darkmarthur/FADETUBE_DJ_MIDI_CONTROLLER/FADETUBE_MIDI/production/TEST_JLC_bom.csv

Designator | Footprint | Quantity | Value | LCSC Part #
ARDUINOPROMICROATMEGA32U4USBC-1 | Sparkfun_Pro_Micro | 1 | SPARKFUN QWIIC PRO MICRO - USB-C
C1 | CAPC1608X90 | 1 | 0.1 µF
C2 | CAPC2012X88N | 1 | 10 µF
FADER1 | TRIM_PTA4553-2215CIB103 | 1 | PTA4553-2215CIB103 10k 45mm
J1_DECK_A1, J2_DECK_B1 | JST_B8B-PH-K-S | 2 | B8B-PH-K-S
ROTARY_ENCODER_BTN1 | XDCR_PEC11R-4220K-S0024 | 1 | PEC11R-4220K-S0024 10k
R_LOAD_A1, R_LOAD_B1, R_PLAY_A1, R_PLAY_B1 | RESC1608X55 | 4 | 470 Ohms
