darkmarthur/FADETUBE_DJ_MIDI_CONTROLLER/3D_PROTOTYPE/FADETUBE_DJ_MIDI_CONTROLLER_Slices.3mf

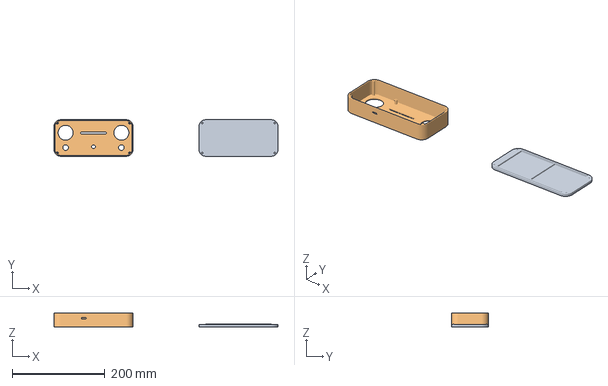
[picture p1: CAD file, 2026-02-12]
3D_PROTOTYPE/FADETUBE_DJ_MIDI_CONTROLLER_Slices.3mf
482.0 x 78.6 x 30.2 mm
FADETUBE_DJ_MIDI_CONTROLLER_v2_Bottom.stl
FADETUBE_DJ_MIDI_CONTROLLER_Top.stl
