darkmarthur/FADETUBE_DJ_MIDI_CONTROLLER/3D_PROTOTYPE/FADETUBE_DJ_MIDI_CONTROLLER_v2_Bottom.stl

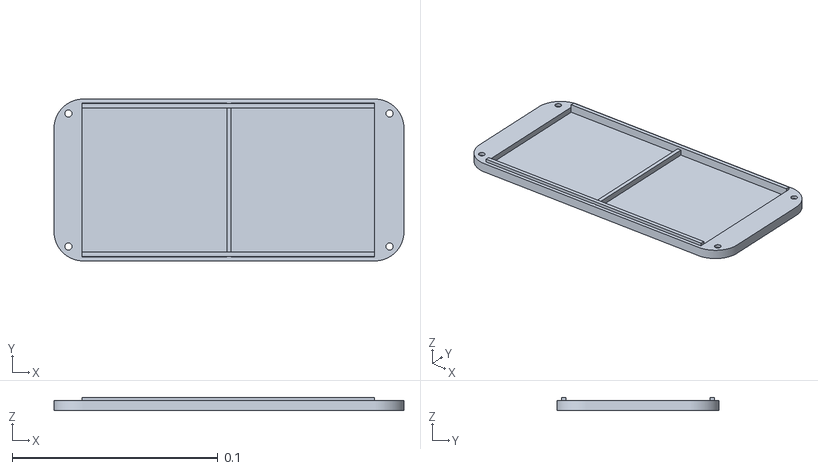
[picture p2: CAD file, 2026-02-12]
3D_PROTOTYPE/FADETUBE_DJ_MIDI_CONTROLLER_v2_Bottom.stl
0.17 x 0.0786 x 0.0065
