darkmarthur/FADETUBE_DJ_MIDI_CONTROLLER/3D_PROTOTYPE/FADETUBE_DJ_MIDI_CONTROLLER_Top.stl

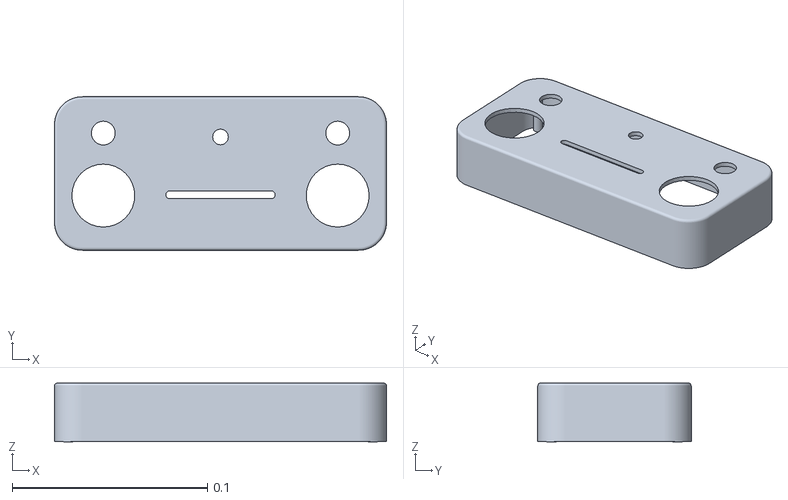
[picture p3: CAD file, 2026-02-12]
3D_PROTOTYPE/FADETUBE_DJ_MIDI_CONTROLLER_Top.stl
0.17 x 0.0786 x 0.0302
