darkmarthur/FADETUBE_DJ_MIDI_CONTROLLER/(list of files, cad)

Other CAD files:
3D_PROTOTYPE/FADETUBE_DJ_MIDI_CONTROLLER.blend
3D_PROTOTYPE/FADETUBE_DJ_MIDI_CONTROLLER_MINI.blend
3D_PROTOTYPE/FADETUBE_DJ_MIDI_CONTROLLER_v2.blend
