darkmarthur/FADETUBE_DJ_MIDI_CONTROLLER/FADETUBE_MIDI/FADETUBE_MIDI_MINI.kicad_pcb

## KiCad design FADETUBE_MIDI/FADETUBE_MIDI_MINI.kicad_pcb (2026-02-12)

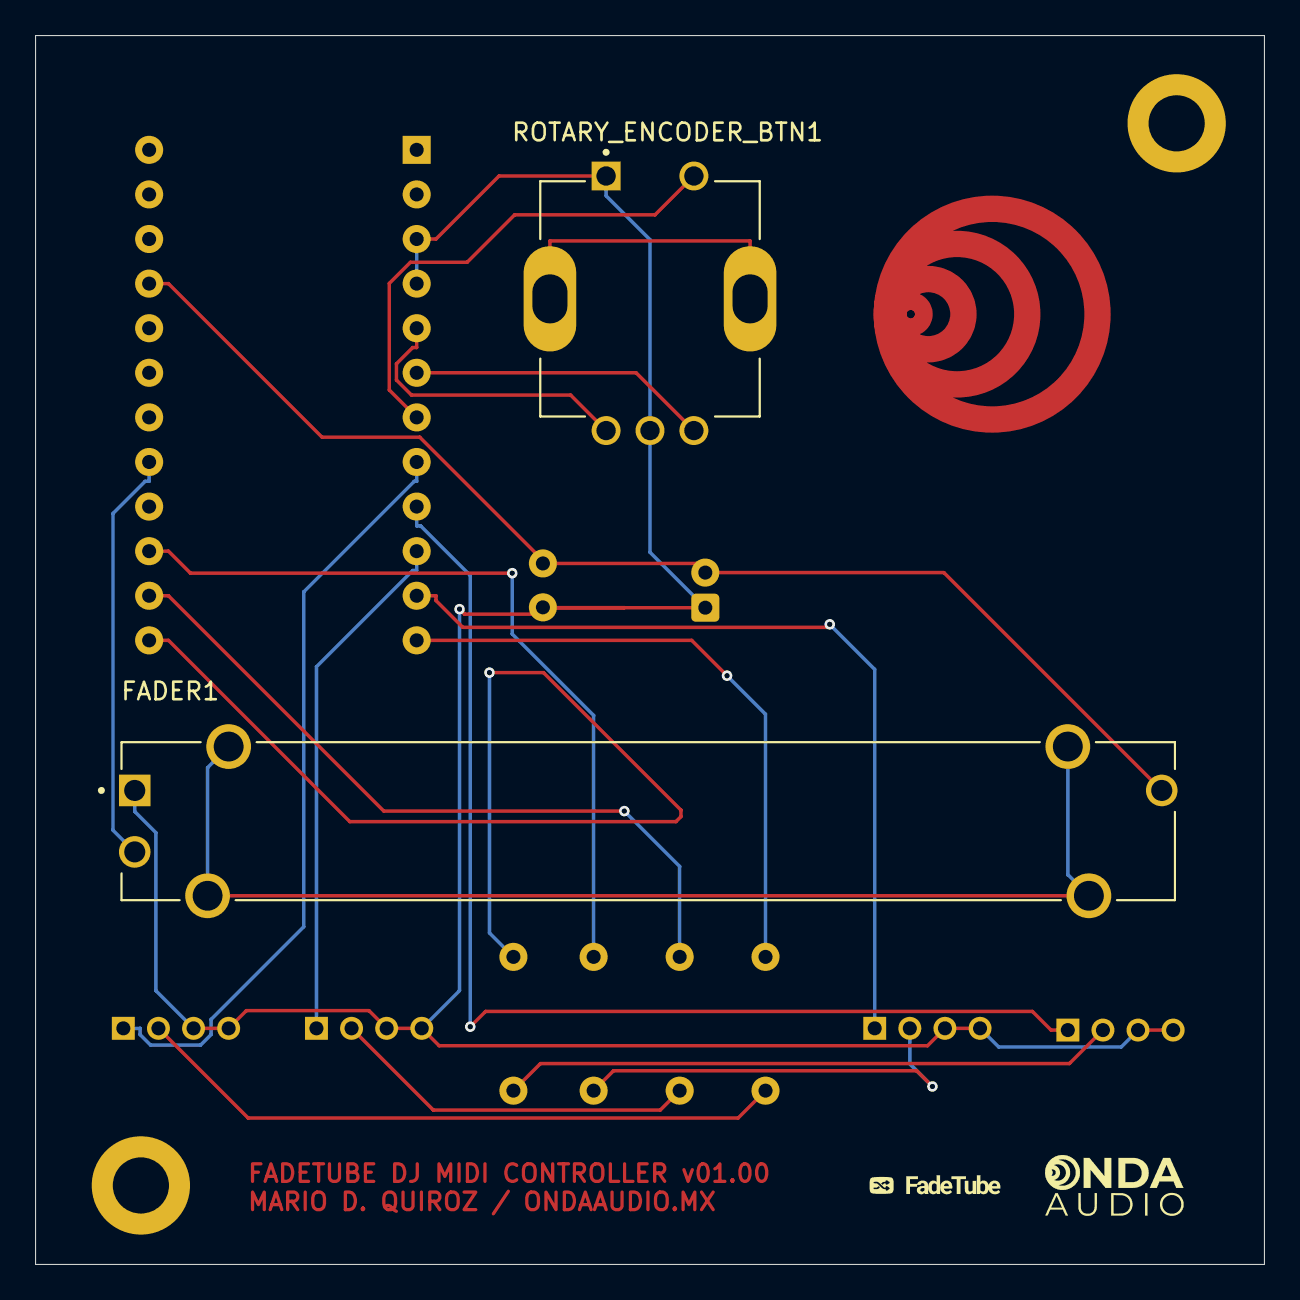
[picture p4: board FADETUBE_MIDI_MINI.kicad_pcb from above]

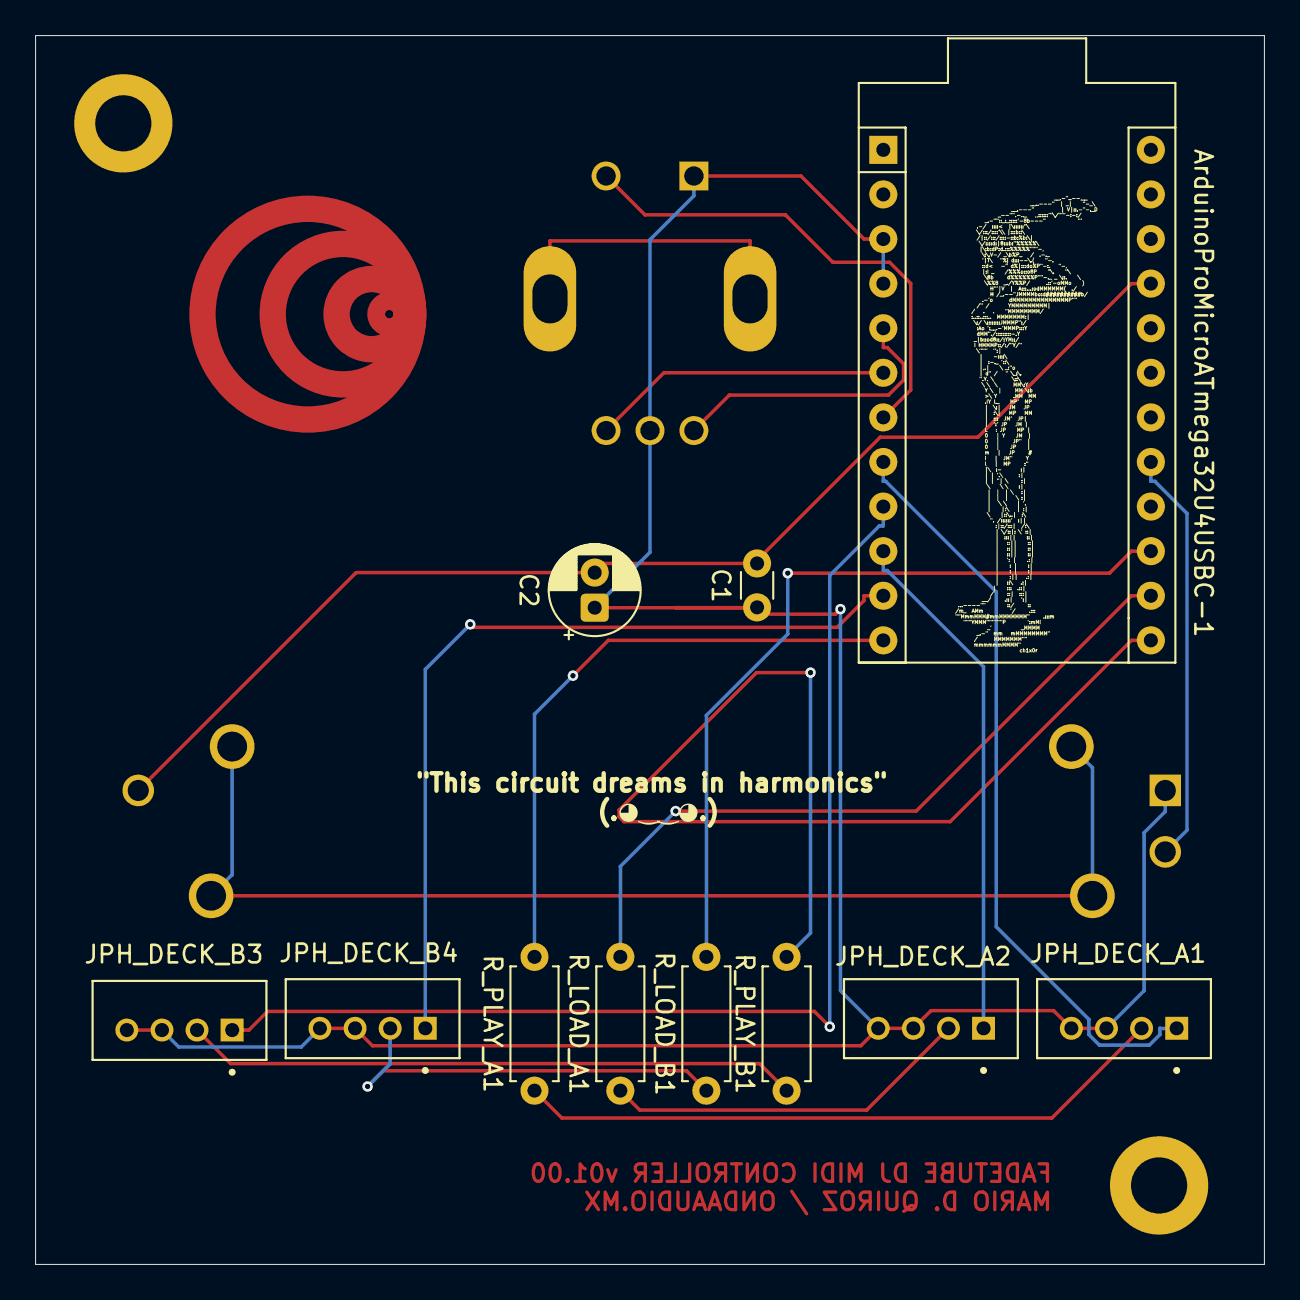
[picture p5: board FADETUBE_MIDI_MINI.kicad_pcb from below]

Board: 2 copper layers, 70.0 x 70.0 mm, 17 parts (11 on the bottom side), 20 nets.

Parts:
ArduinoProMicroATmega32U4USBC-1: SPARKFUN QWIIC PRO MICRO - USB-C; Sparkfun_Pro_Micro
C1: 0.1 µF; C_Disc_D3.0mm_W1.6mm_P2.50mm
C2: 10 µF; CP_Radial_D5.0mm_P2.00mm
FADER1: PTA4553-2215CIB103 10k 45mm; TRIM_PTA4553-2215CIB103
FADETUBE-LOGO: LOGO; fadetube-logo
JPH_DECK_A1, JPH_DECK_A2: B4B-PH-K-S; JST_B4B-PH-K-S
JPH_DECK_B3, JPH_DECK_B4: B4B-PH-K-S; JST_B4B-PH-K-S
MH1, MH2: MountingHole_3.2mm_M3_DIN965_Pad
ONDAAUDIO-LOGO: LOGO; onda-audio-logo
ROTARY_ENCODER_BTN1: PEC11R-4220K-S0024 10k; XDCR_PEC11R-4220K-S0024
R_LOAD_A1: 470 Ohms; R_Axial_DIN0207_L6.3mm_D2.5mm_P7.62mm_Horizontal
R_LOAD_B1: 470 Ohms; R_Axial_DIN0207_L6.3mm_D2.5mm_P7.62mm_Horizontal
R_PLAY_A1: 470 Ohms; R_Axial_DIN0207_L6.3mm_D2.5mm_P7.62mm_Horizontal
R_PLAY_B1: 470 Ohms; R_Axial_DIN0207_L6.3mm_D2.5mm_P7.62mm_Horizontal

Connections:
GND: ArduinoProMicroATmega32U4USBC-1.3 (GND), ArduinoProMicroATmega32U4USBC-1.4 (GND), C1.1, C2.1, FADER1.1, JPH_DECK_A1.3, JPH_DECK_A1.4, JPH_DECK_A2.3, JPH_DECK_A2.4, JPH_DECK_B3.3, JPH_DECK_B3.4, JPH_DECK_B4.3, JPH_DECK_B4.4, ROTARY_ENCODER_BTN1.1, ROTARY_ENCODER_BTN1.C (COM)
unnamed: ArduinoProMicroATmega32U4USBC-1.5 (D2), ROTARY_ENCODER_BTN1.A
unnamed: ArduinoProMicroATmega32U4USBC-1.7 (D4/A6), ROTARY_ENCODER_BTN1.2
unnamed: ArduinoProMicroATmega32U4USBC-1.10 (D7), JPH_DECK_A2.1
unnamed: ArduinoProMicroATmega32U4USBC-1.11 (D8/A8), JPH_DECK_B4.1
unnamed: ArduinoProMicroATmega32U4USBC-1.15 (D14), R_LOAD_B1.2
unnamed: ArduinoProMicroATmega32U4USBC-1.14 (D16), R_LOAD_A1.2
unnamed: ArduinoProMicroATmega32U4USBC-1.17 (D18/A0), FADER1.2
unnamed: ArduinoProMicroATmega32U4USBC-1.21 (VCC), C1.2, C2.2, FADER1.3
unnamed: ArduinoProMicroATmega32U4USBC-1.6 (~D3), ROTARY_ENCODER_BTN1.B
unnamed: ArduinoProMicroATmega32U4USBC-1.8 (~D5), JPH_DECK_A1.1
unnamed: ArduinoProMicroATmega32U4USBC-1.9 (~D6/A7), JPH_DECK_B3.1
unnamed: ArduinoProMicroATmega32U4USBC-1.12 (~D9/A9), R_PLAY_A1.2
unnamed: ArduinoProMicroATmega32U4USBC-1.13 (~D10/A10), R_PLAY_B1.2
unnamed: FADER1.SH1 (SHIELD), FADER1.SH2 (SHIELD), FADER1.SH3 (SHIELD), FADER1.SH4 (SHIELD)
unnamed: JPH_DECK_A1.2, R_PLAY_A1.1
unnamed: JPH_DECK_A2.2, R_LOAD_A1.1
unnamed: JPH_DECK_B3.2, R_PLAY_B1.1
unnamed: JPH_DECK_B4.2, R_LOAD_B1.1
unnamed: ROTARY_ENCODER_BTN1.SH1 (SHIELD), ROTARY_ENCODER_BTN1.SH2 (SHIELD)
