darkmarthur/FADETUBE_DJ_MIDI_CONTROLLER/(commit log)

2026-01-20 restructure project
    [FADETUBE_MIDI.kicad_pcb, FADETUBE_MIDI.kicad_sch]
2026-01-20 test smd
    [FADETUBE_MIDI.kicad_pcb, FADETUBE_MIDI.kicad_sch]
2026-01-21 MVP PRIOR MANUFACTURING
    [FADETUBE_MIDI.kicad_pcb, FADETUBE_MIDI.kicad_sch, FADETUBE_MIDI_MULTI.kicad_pcb, TEST_JLC_bom.csv, TEST_JLC_designators.csv, TEST_JLC_positions.csv]
2026-01-21 BOMLIST INCLUDED
    [BOM-FADETUBE_MIDI-NO-ARDUINO.csv, BOM-FADETUBE_MIDI.csv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]
2026-01-22 mvp tes pcbway and jlc
    [FADETUBE_MIDI.kicad_pcb, TEST_JLC_bom.csv, TEST_JLC_designators.csv, TEST_JLC_positions.csv]
2026-01-23 add blender file
    [FADETUBE_DJ_MIDI_CONTROLLER.blend]
2026-01-27 ADVANCDED VERTION
    [BOM-FADETUBE_MIDI-NO-ARDUINO.csv, BOM-FADETUBE_MIDI.csv, FADETUBE_DJ_MIDI_CONTROLLER.blend, FADETUBE_DJ_MIDI_CONTROLLER_MINI.blend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]
2026-01-27 updated pcb
    [FADETUBE_DJ_MIDI_CONTROLLER.blend]
2026-02-10 3d Models
    [FADETUBE_DJ_MIDI_CONTROLLER.blend, FADETUBE_DJ_MIDI_CONTROLLER_Superior.stl, FADETUBE_DJ_MIDI_CONTROLLER_v2.blend]
2026-02-11 3d Updates
    [FADETUBE_DJ_MIDI_CONTROLLER_Slices.3mf, FADETUBE_DJ_MIDI_CONTROLLER_Top.stl, FADETUBE_DJ_MIDI_CONTROLLER_v2.blend, FADETUBE_DJ_MIDI_CONTROLLER_v2_Bottom.stl]
2026-02-12 new updates
    [FADETUBE_MIDI.kicad_pcb, FADETUBE_MIDI.kicad_sch, FADETUBE_MIDI_MINI.kicad_pcb, FADETUBE_MIDI_MINI.kicad_sch]
